runger1101001/roboesc_v3_MKR/README.md

# roboesc_v3_MKR

A simple breakout board for the DRV8316 3-phase motor driver in Arduino MKR shield format.
