runger1101001/roboesc_v3_MKR/ESCv1.1.kicad_pcb

## KiCad design ESCv1.1.kicad_pcb (2021-05-21)

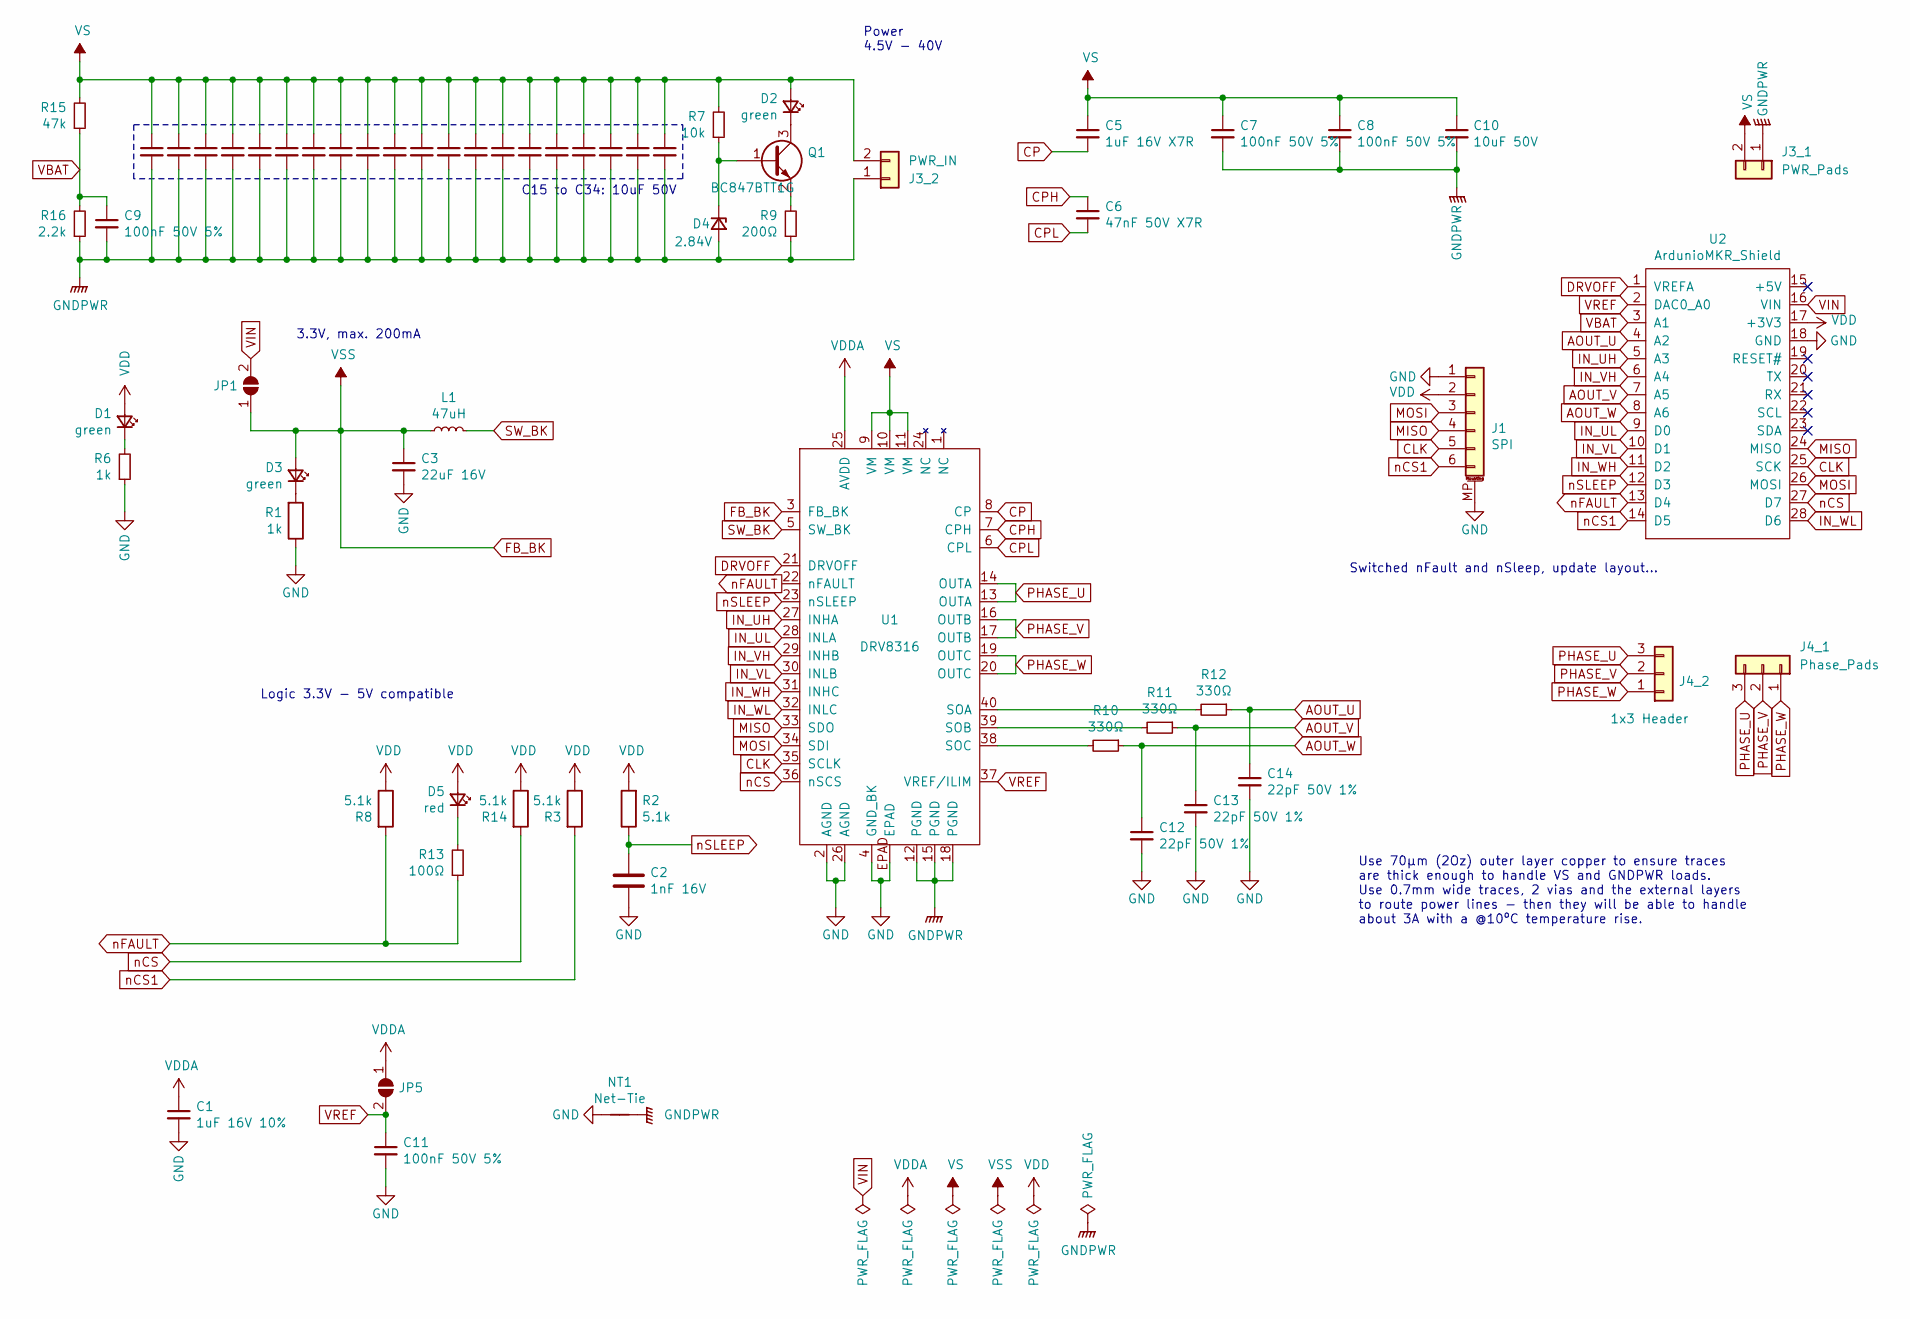
[picture p1: schematic ESCv1.1.sch]

Parts:
C1: 1uF 16V 10%; C_0402_1005Metric; Part GRM155R61C105KA12D
C2: 1nF 16V; C_0402_1005Metric; Part 0402YC102KAT2A
C3: 22uF 16V; C_0805_2012Metric; Part CL21A226KQQNNNG
C5: 1uF 16V X7R; C_0603_1608Metric; Part 0603YC105JAT2A
C6: 47nF 50V X7R; C_0402_1005Metric; Part GRM155R71H473KE14D
C7, C8, C9, C11: 100nF 50V 5%; C_0402_1005Metric; Part GRM155C71H104JE19D
C10, C15, C16, C17, C18, C19, C20, C21, C22, C23, C24, C25, C26, C27, C28, C29, C30, C31, C32, C33, C34: 10uF 50V; C_0805_2012Metric; Part GRM21BR61H106KE43L
C12, C13, C14: 22pF 50V 1%; C_0402_1005Metric; Part GRM1555C1H220FA01D
D1, D2, D3: green; LED_0402_1005Metric; Part 150040VS73240
D4: 2.84V; D_SOD-523; Part CZRU52C2V7-HF
D5: red; LED_0402_1005Metric; Part 150040RS73240
J1: ST_SH_SM06B-SRSS-TB_1x06-1MP; JST_SH_SM06B-SRSS-TB_1x06-1MP_P1.00mm_Horizontal; Part ST_SH_SM06B-SRSS-TB_1x06-1MP
J3_1: PWR_Pads; EdgeSolderPads2x_Trapezoidal_3mmx3mmx3mm
J3_2: PWR_IN; TerminalBlock_RND_205-00001_1x02_P5.00mm_Horizontal
J4_1: Phase_Pads; EdgeSolderPads3x_Trapezoidal_3mmx3mmx3mm
J4_2: 1x3 Header; TerminalBlock_RND_205-00277_1x03_P5.00mm_Vertical
JP1, JP5: VSS2VDD; SolderJumper-2_P1.3mm_Open_TrianglePad1.0x1.5mm
L1: 47uH; L_1210_3225Metric; Part L1210R470KDWIT
NT1: Net-Tie; NetTie-2_THT_Pad0.3mm
Q1: BC847BTT1G; SOT-416; Part BC847BTT1G
R1, R6: 1k; R_0402_1005Metric
R2, R3, R8, R14: 5.1k; R_0402_1005Metric
R7: 10k; R_0402_1005Metric
R9: 200Ω; R_0402_1005Metric
R10, R11, R12: 330Ω; R_0402_1005Metric
R13: 100Ω; R_0402_1005Metric
R15: 47k; R_0402_1005Metric
R16: 2.2k; R_0402_1005Metric
U1: DRV8316; vQFN-40_EP_5x7_Pitch0.5mm; Part DRV8316
U2: ArdunioMKR_Shield; ArduinoMKR_Shield

Connections:
AOUT_U: C14.1, R12.1, U2.4 (A2)
AOUT_V: C13.1, R11.1, U2.7 (A5)
AOUT_W: C12.1, R10.1, U2.8 (A6)
CLK: J1.5, U1.35 (SCLK), U2.25 (SCK)
CP: C5.2, U1.8 (CP)
CPH: C6.1, U1.7 (CPH)
CPL: C6.2, U1.6 (CPL)
DRVOFF: U1.21 (DRVOFF), U2.1 (VREFA)
FB_BK: C3.1, D3.2 (A), JP1.1 (A), L1.1, U1.3 (FB_BK)
GND: C1.2, C2.2, C3.2, C11.2, C12.2, C13.2, C14.2, J1.1, J1.MP (MountPin), NT1.1, R1.1, R6.1, U1.2 (AGND), U1.4 (GND_BK), U1.26 (AGND), U1.EPAD, U2.18 (GND)
GNDPWR: C7.2, C8.2, C9.2, C10.2, C15.2, C16.2, C17.2, C18.2, C19.2, C20.2, C21.2, C22.2, C23.2, C24.2, C25.2, C26.2, C27.2, C28.2, C29.2, C30.2, C31.2, C32.2, C33.2, C34.2, D4.2 (A), J3_1.1, J3_2.1, NT1.2, R9.1, R16.1, U1.12 (PGND), U1.15 (PGND), U1.18 (PGND)
IN_UH: U1.27 (INHA), U2.5 (A3)
IN_UL: U1.28 (INLA), U2.9 (D0)
IN_VH: U1.29 (INHB), U2.6 (A4)
IN_VL: U1.30 (INLB), U2.10 (D1)
IN_WH: U1.31 (INHC), U2.11 (D2)
IN_WL: U1.32 (INLC), U2.28 (D6)
MISO: J1.4, U1.33 (SDO), U2.24 (MISO)
MOSI: J1.3, U1.34 (SDI), U2.26 (MOSI)
unnamed: D1.1 (K), R6.2
unnamed: D2.1 (K), Q1.3 (C)
unnamed: D3.1 (K), R1.2
unnamed: D4.1 (K), Q1.1 (B), R7.1
unnamed: D5.1 (K), R13.2
unnamed: Q1.2 (E), R9.2
unnamed: R10.2, U1.38 (SOC)
unnamed: R11.2, U1.39 (SOB)
unnamed: R12.2, U1.40 (SOA)
PHASE_U: J4_1.3, J4_2.3, U1.13 (OUTA), U1.14 (OUTA)
PHASE_V: J4_1.2, J4_2.2, U1.16 (OUTB), U1.17 (OUTB)
PHASE_W: J4_1.1, J4_2.1, U1.19 (OUTC), U1.20 (OUTC)
SW_BK: L1.2, U1.5 (SW_BK)
VBAT: C9.1, R15.1, R16.2, U2.3 (A1)
VDD: D1.2 (A), D5.2 (A), J1.2, R2.2, R3.1, R8.1, R14.1, U2.17 (+3V3)
VDDA: C1.1, JP5.1 (A), U1.25 (AVDD)
VIN: JP1.2 (B), U2.16 (VIN)
VREF: C11.1, JP5.2 (B), U1.37 (VREF/ILIM), U2.2 (DAC0_A0)
VS: C5.1, C7.1, C8.1, C10.1, C15.1, C16.1, C17.1, C18.1, C19.1, C20.1, C21.1, C22.1, C23.1, C24.1, C25.1, C26.1, C27.1, C28.1, C29.1, C30.1, C31.1, C32.1, C33.1, C34.1, D2.2 (A), J3_1.2, J3_2.2, R7.2, R15.2, U1.9 (VM), U1.10 (VM), U1.11 (VM)
nCS: R14.2, U1.36 (nSCS), U2.27 (D7)
nCS1: J1.6, R3.2, U2.14 (D5)
nFAULT: R8.2, R13.1, U1.22 (nFAULT), U2.13 (D4)
nSLEEP: C2.1, R2.1, U1.23 (nSLEEP), U2.12 (D3)

Notes on the sheet:
Logic 3.3V - 5V compatible
Power 4.5V - 40V
Use 70µm (2Oz) outer layer copper to ensure traces are thick enough to handle VS and GNDPWR loads. Use 0.7mm wide traces, 2 vias and the external layers to route power lines - then they will be able to handle about 3A with a @10ºC temperature rise.
3.3V, max. 200mA
C15 to C34: 10uF 50V
Switched nFault and nSleep, update layout…

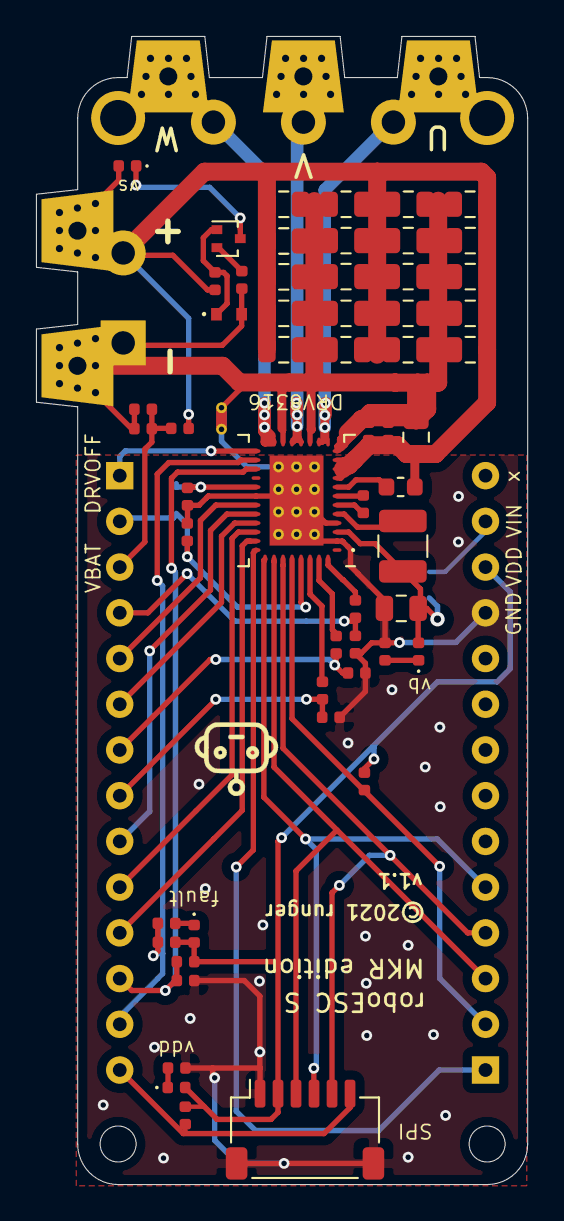
[picture p2: board ESCv1.1.kicad_pcb from above]

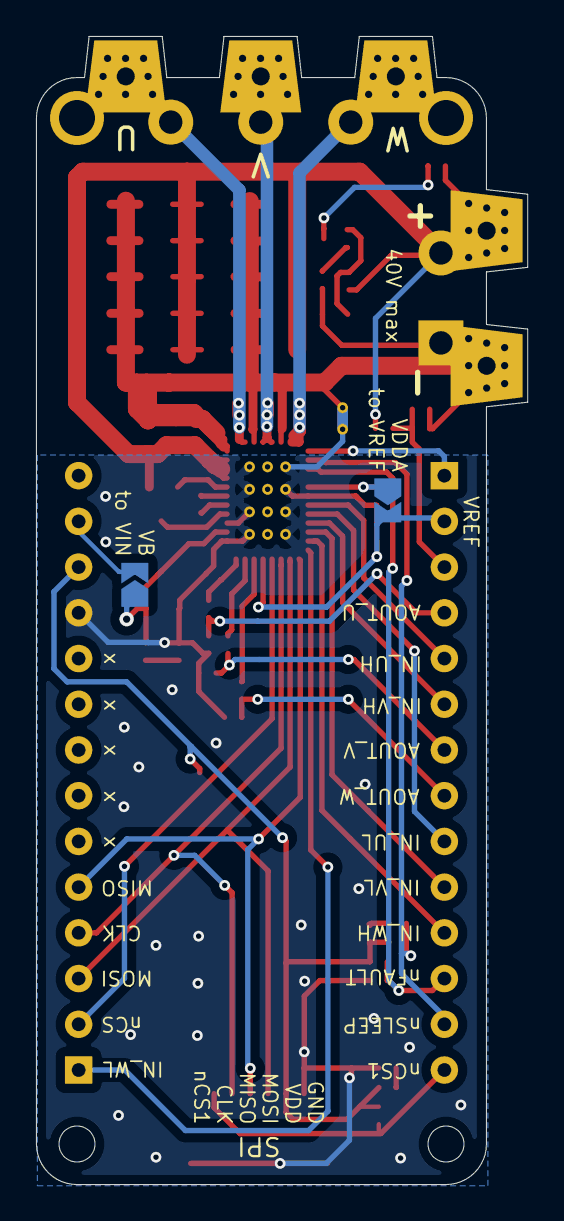
[picture p3: board ESCv1.1.kicad_pcb from below]

Board: 2 copper layers, 27.3 x 63.8 mm, 64 parts (3 on the bottom side), 42 nets.
