runger1101001/roboesc_v3_MKR/(commit log)

2021-05-07 v1.1 update, fixed pin assignment for nFAULT
    [ESCv1.1-B_Cu.gbl, ESCv1.1-B_Mask.gbs, ESCv1.1-B_Paste.gbp, ESCv1.1-B_SilkS.gbo, ESCv1.1-Edge_Cuts.gm1, ESCv1.1-F_Cu.gtl, ESCv1.1-F_Mask.gts, ESCv1.1-F_Paste.gtp]
2021-05-21 fixed U1 footprint's solder mask
    [ESCv1.1-B_Cu.gbl, ESCv1.1-B_Mask.gbs, ESCv1.1-B_Paste.gbp, ESCv1.1-B_SilkS.gbo, ESCv1.1-Edge_Cuts.gm1, ESCv1.1-F_Cu.gtl, ESCv1.1-F_Mask.gts, ESCv1.1-F_Paste.gtp]
