runger1101001/roboesc_v3_MKR/(notices)

Notices in the files:
ESCv1.1.kicad_pcb:
©2021 runger
